vdesmedt/ElectronicLoad/Electonic/MainBoard.brd

## EAGLE design Electonic/MainBoard.brd (2020-11-04)

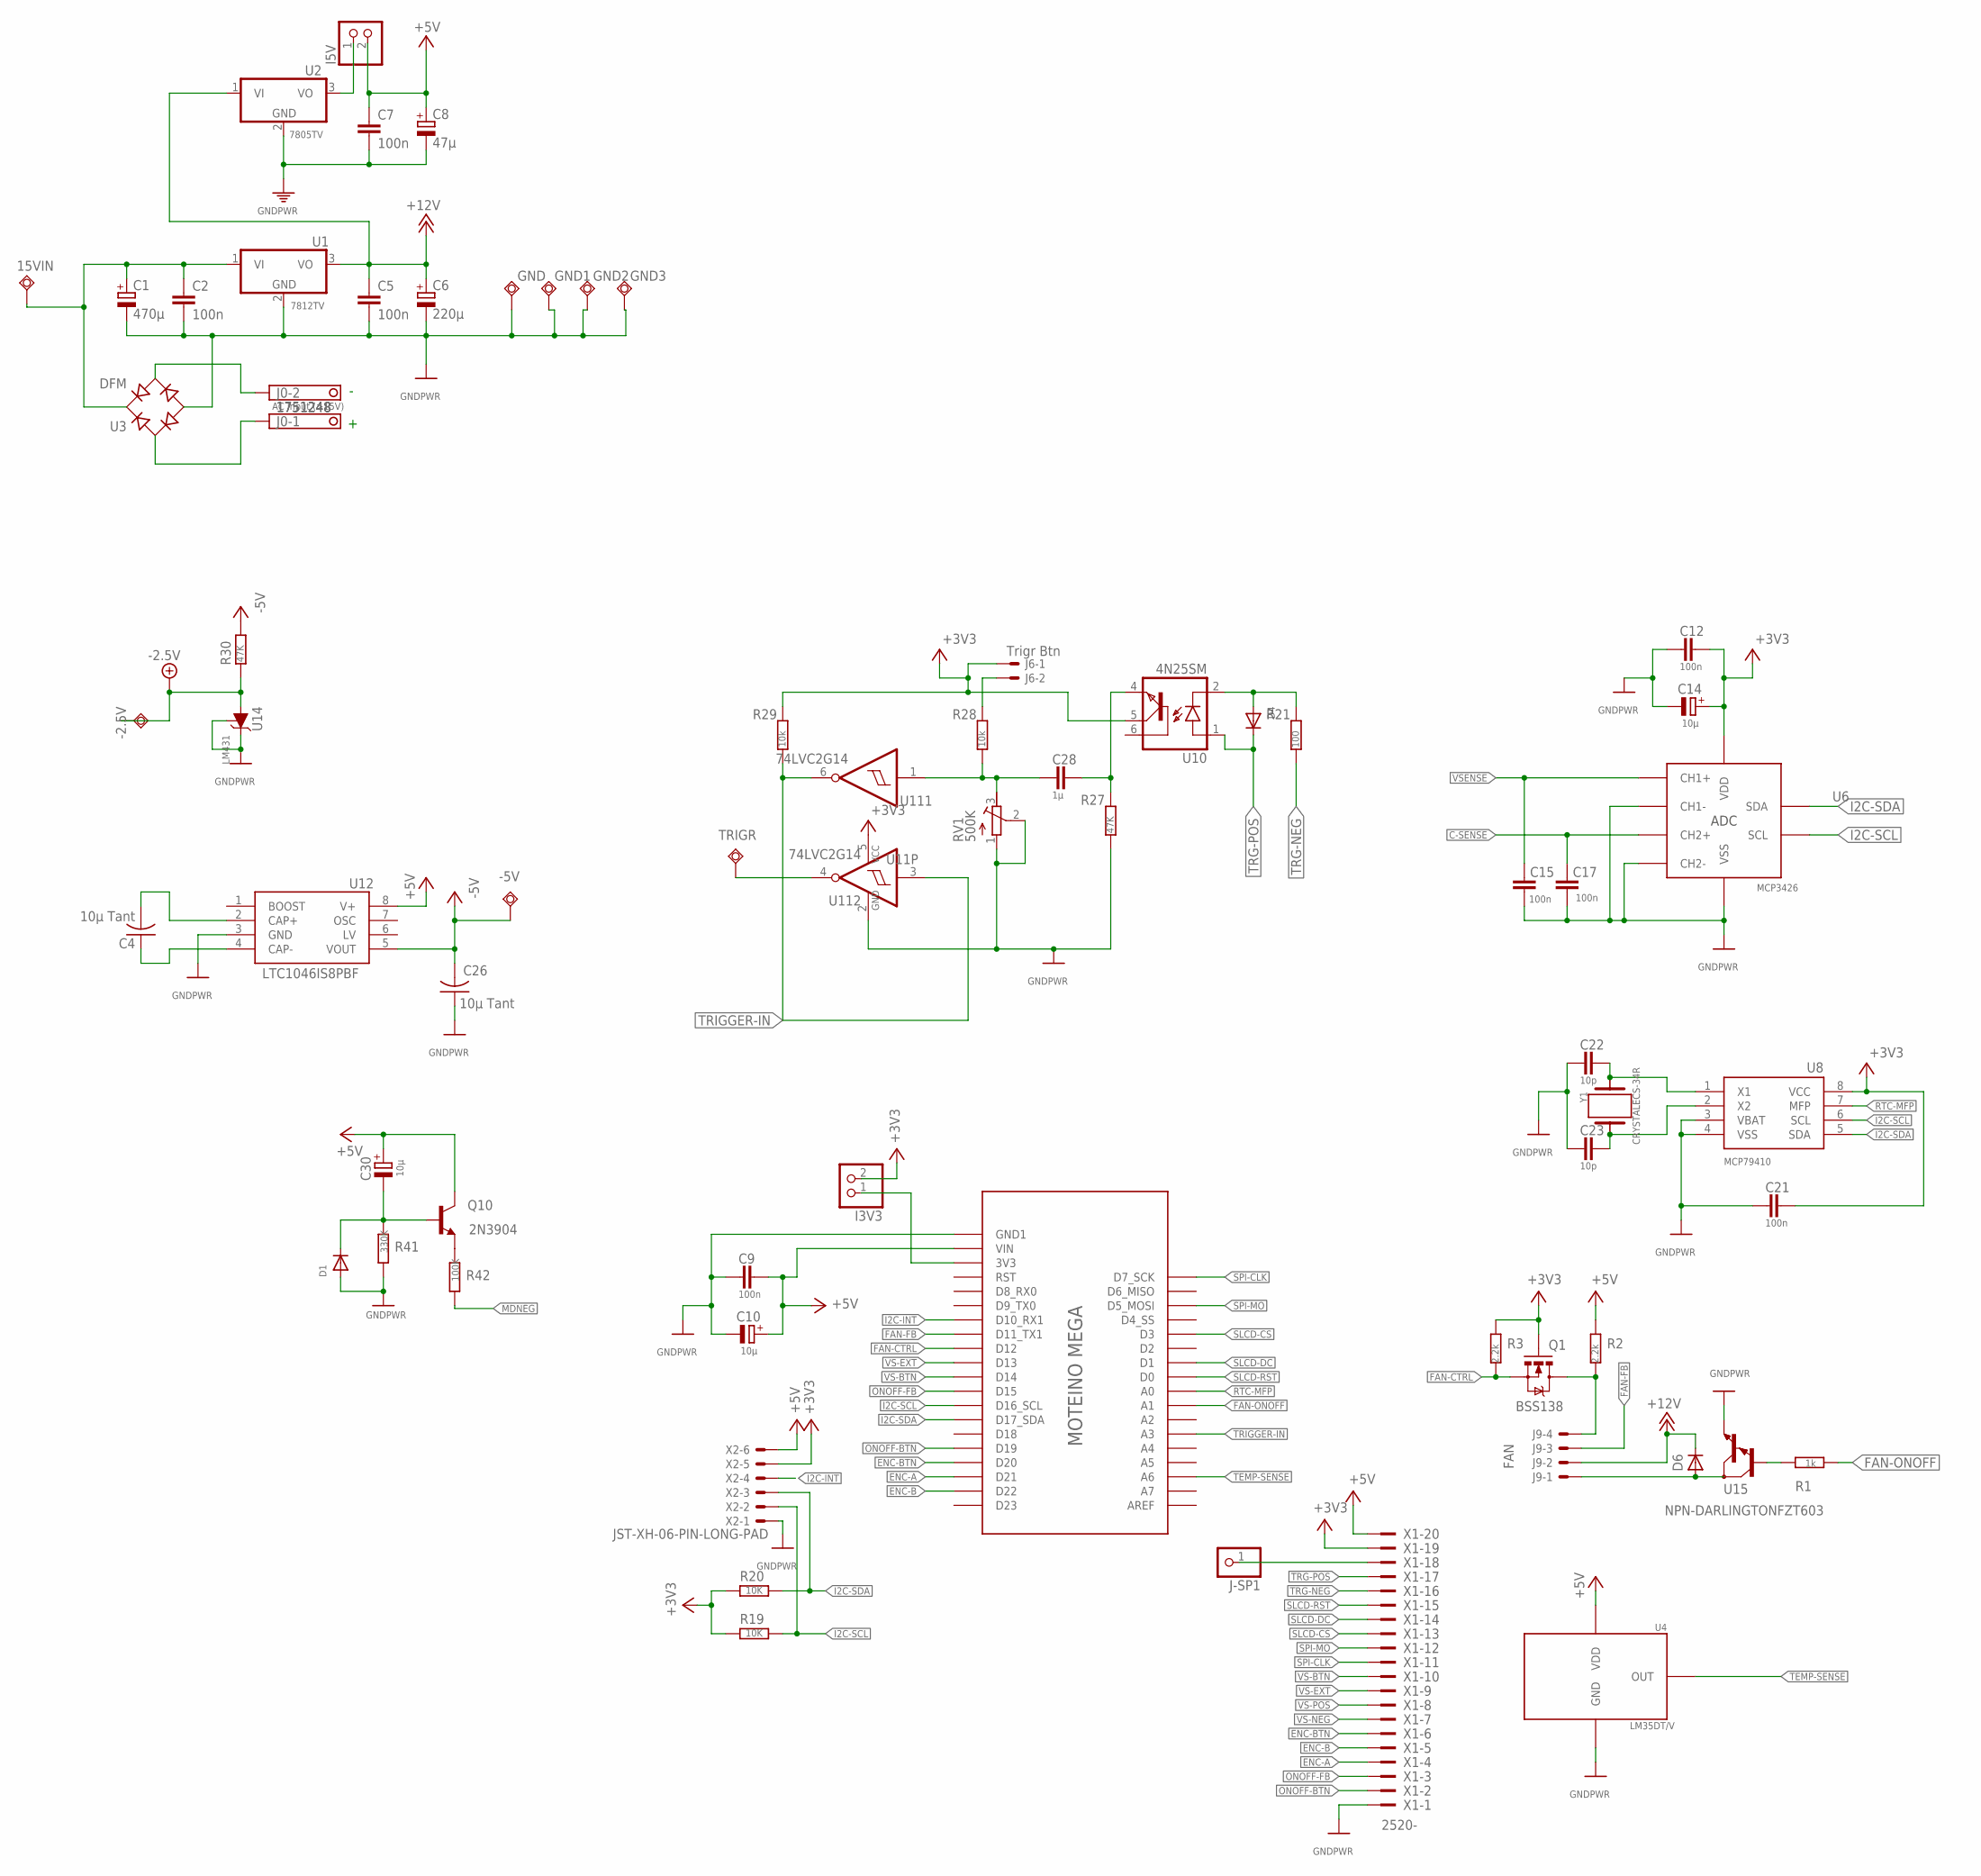
[picture p1: schematic MainBoard.sch, sheet 1]

Parts:
15VIN: TEST-POINT4952; TP-KEYSTONE-4952
-2.5V, -5V: TEST-POINT4952; TP-KEYSTONE-4952
C1: 470µ; E5-10,5
C2, C5, C7, C9, C12, C15, C17, C21: 100n; C0805K
C4, C26: 10µ Tant; C1210
C6: 220µ; E5-10,5
C8: 47µ; E5-5
C10, C14, C30: 10µ; E2-5
C22, C23: 10p; C0805K
C28: 1µ; C0805K
D1, D4: DIODESOD-323F; SOD-323F
D6: DIODE_SOD-123FL; SOD-123FL
GND, GND1, GND2, GND3: TEST-POINT4952; TP-KEYSTONE-4952
I3V3, I5V: PINHD-1X2; 1X02
J0: 1751248
J6: Trigr Btn; JST-XH-02-PACKAGE-ROUND-PAD
J9: FAN; JST-XH-04-PACKAGE-ROUND-PAD
J-SP1: PINHD-1X1; 1X01
Q1: BSS138; SOT23
Q10: 2N3904; TO92
R1: 1k; R0805
R2, R3: 2.2k; R0805
R19, R20: 10K; R0805
R21: 100; R0805
R27, R30: 47K; R0805
R28, R29: 10k; R0805
R41: 330K; R0805
R42: 100K; R0805
RV1: 500K; RTRIM3296W
TRIGR: TEST-POINT4952; TP-KEYSTONE-4952
U1: 7812TV; TO220V
U2: 7805TV; TO220V
U3: DFM
U4: LM35DT/V; TO220V
U6: MCP3426; SO8
U8: MCP79410; SOIC127P600X175-8N
U10: 4N25SM; DIL6-SMD
U11: 74LVC2G14; SOT23-6
U12: LTC1046IS8PBF; SOIC127P599X175-8N
U14: LM431; SOT23
U15: NPN-DARLINGTONFZT603; SOT223
U$1: MOTEINO_MEGA_SIMPLE
X1: 2520-; PAK100/2500-20
X2: JST-XH-06-PIN-LONG-PAD; JST-XH-06-PACKAGE-LONG-PAD
Y1: CRYSTALECS-34R; ECS32712534RRTR

Connections:
+3V3: C12.1, C14.+, C21.1, I3V3.2, J6.1, Q1.1 (G), R3.2, R19.2, R20.2, R29.2, U6.3 (VDD), U8.8 (VCC), U10.5 (COL), U11.5 (VCC), X1.19, X2.5
+5V: C7.1, C8.+, C9.1, C10.+, C30.+, I5V.2, Q10.1 (C), R2.2, U4.1 (VDD), U12.8 (V+), U$1.VIN, U$1.VIN_2 (VIN), X1.20, X2.6; also elsewhere on the board
+12V: C5.1, C6.+, D6.C, J9.2, U1.3 (VO), U2.1 (VI)
-2.5V: -2.5V.P$1, R30.1, U14.3 (A); also elsewhere on the board
-5V: -5V.P$1, C26.2, R30.2, U12.5 (VOUT); also elsewhere on the board
C-SENSE: C17.2, U6.7 (CH2+); also elsewhere on the board
ENC-A: U$1.D21, X1.4
ENC-B: U$1.D22, X1.5
ENC-BTN: U$1.D20, X1.6
FAN-CTRL: Q1.2 (S), R3.1, U$1.D12
FAN-CTRL-5V: J9.4, Q1.3 (D), R2.1
FAN-FB: J9.3, U$1.D11 (D11_TX1)
FAN-ONOFF: R1.1, U$1.A1
GND: C1.-, C2.2, C5.2, C6.-, C7.2, C8.-, C9.2, C10.-, C12.2, C14.-, C15.2, C17.1, C21.2, C22.2, C23.2, C26.1, D1.A, GND.P$1, GND1.P$1, GND2.P$1, GND3.P$1, R27.1, R41.2, RV1.1 (A), RV1.2 (S), U1.2 (GND), U2.2 (GND), U3.-, U4.2 (GND), U6.2 (CH1-), U6.6 (VSS), U6.8 (CH2-), U8.3 (VBAT), U8.4 (VSS), U11.2 (GND), U12.3 (GND), U14.1 (C), U14.2 (ADJ), U15.3 (E), U$1.GND1, U$1.GND_2 (GND1), X1.1, X2.1; also elsewhere on the board
I2C-INT: U$1.D10 (D10_RX1), X2.4
I2C-SCL: R19.1, U6.5 (SCL), U8.6 (SCL), U$1.D16 (D16_SCL), X2.2; also elsewhere on the board
I2C-SDA: R20.1, U6.4 (SDA), U8.5 (SDA), U$1.D17 (D17_SDA), X2.3; also elsewhere on the board
MDNEG: R42.2; also elsewhere on the board
unnamed: TRIGR.P$1, U11.4 (O)
unnamed: D6.A, J9.1, U15.2 (C), U15.4 (C)
unnamed: I5V.1, U2.3 (VO)
unnamed: I3V3.1, U$1.3V3, U$1.3V3_2 (3V3)
unnamed: 15VIN.P$1, C1.+, C2.1, U1.1 (VI), U3.+
unnamed: J0.1, U3.A1 (AC1)
unnamed: J0.2, U3.A2 (AC2)
unnamed: C4.2, U12.2 (CAP+)
unnamed: J-SP1.1, X1.18
unnamed: C4.1, U12.4 (CAP-)
unnamed: C28.2, R28.1, RV1.3 (E), U11.1 (I)
unnamed: C28.1, R27.2, U10.4 (EMI)
unnamed: D4.A, R21.2, U10.2 (C)
unnamed: J6.2, R28.2
unnamed: Q10.3 (E), R42.1
unnamed: C30.-, D1.C, Q10.2 (B), R41.1
ONOFF-BTN: U$1.D19, X1.2
ONOFF-FB: U$1.D15, X1.3
RTC-MFP: U8.7 (MFP), U$1.A0
RTCX1: C22.1, U8.1 (X1), Y1.1
RTCX2: C23.1, U8.2 (X2), Y1.2
SLCD-CS: U$1.D3, X1.13
SLCD-DC: U$1.D1, X1.14
SLCD-RST: U$1.D0, X1.15
SPI-CLK: U$1.D7 (D7_SCK), X1.11
SPI-MO: U$1.D5 (D5_MOSI), X1.12
TEMP-SENSE: U4.3 (OUT), U$1.A6
TRG-NEG: R21.1, X1.16
TRG-POS: D4.C, U10.1 (A), X1.17
TRIGGER-IN: R29.1, U11.3 (I), U11.6 (O), U$1.A3
U15IN: R1.2, U15.1 (B)
VS-BTN: U$1.D14, X1.10
VS-EXT: U$1.D13, X1.9
VS-NEG: X1.7; also elsewhere on the board
VS-POS: X1.8; also elsewhere on the board
VSENSE: C15.1, U6.1 (CH1+); also elsewhere on the board

Notes on the sheet:
AC Input (>15V)

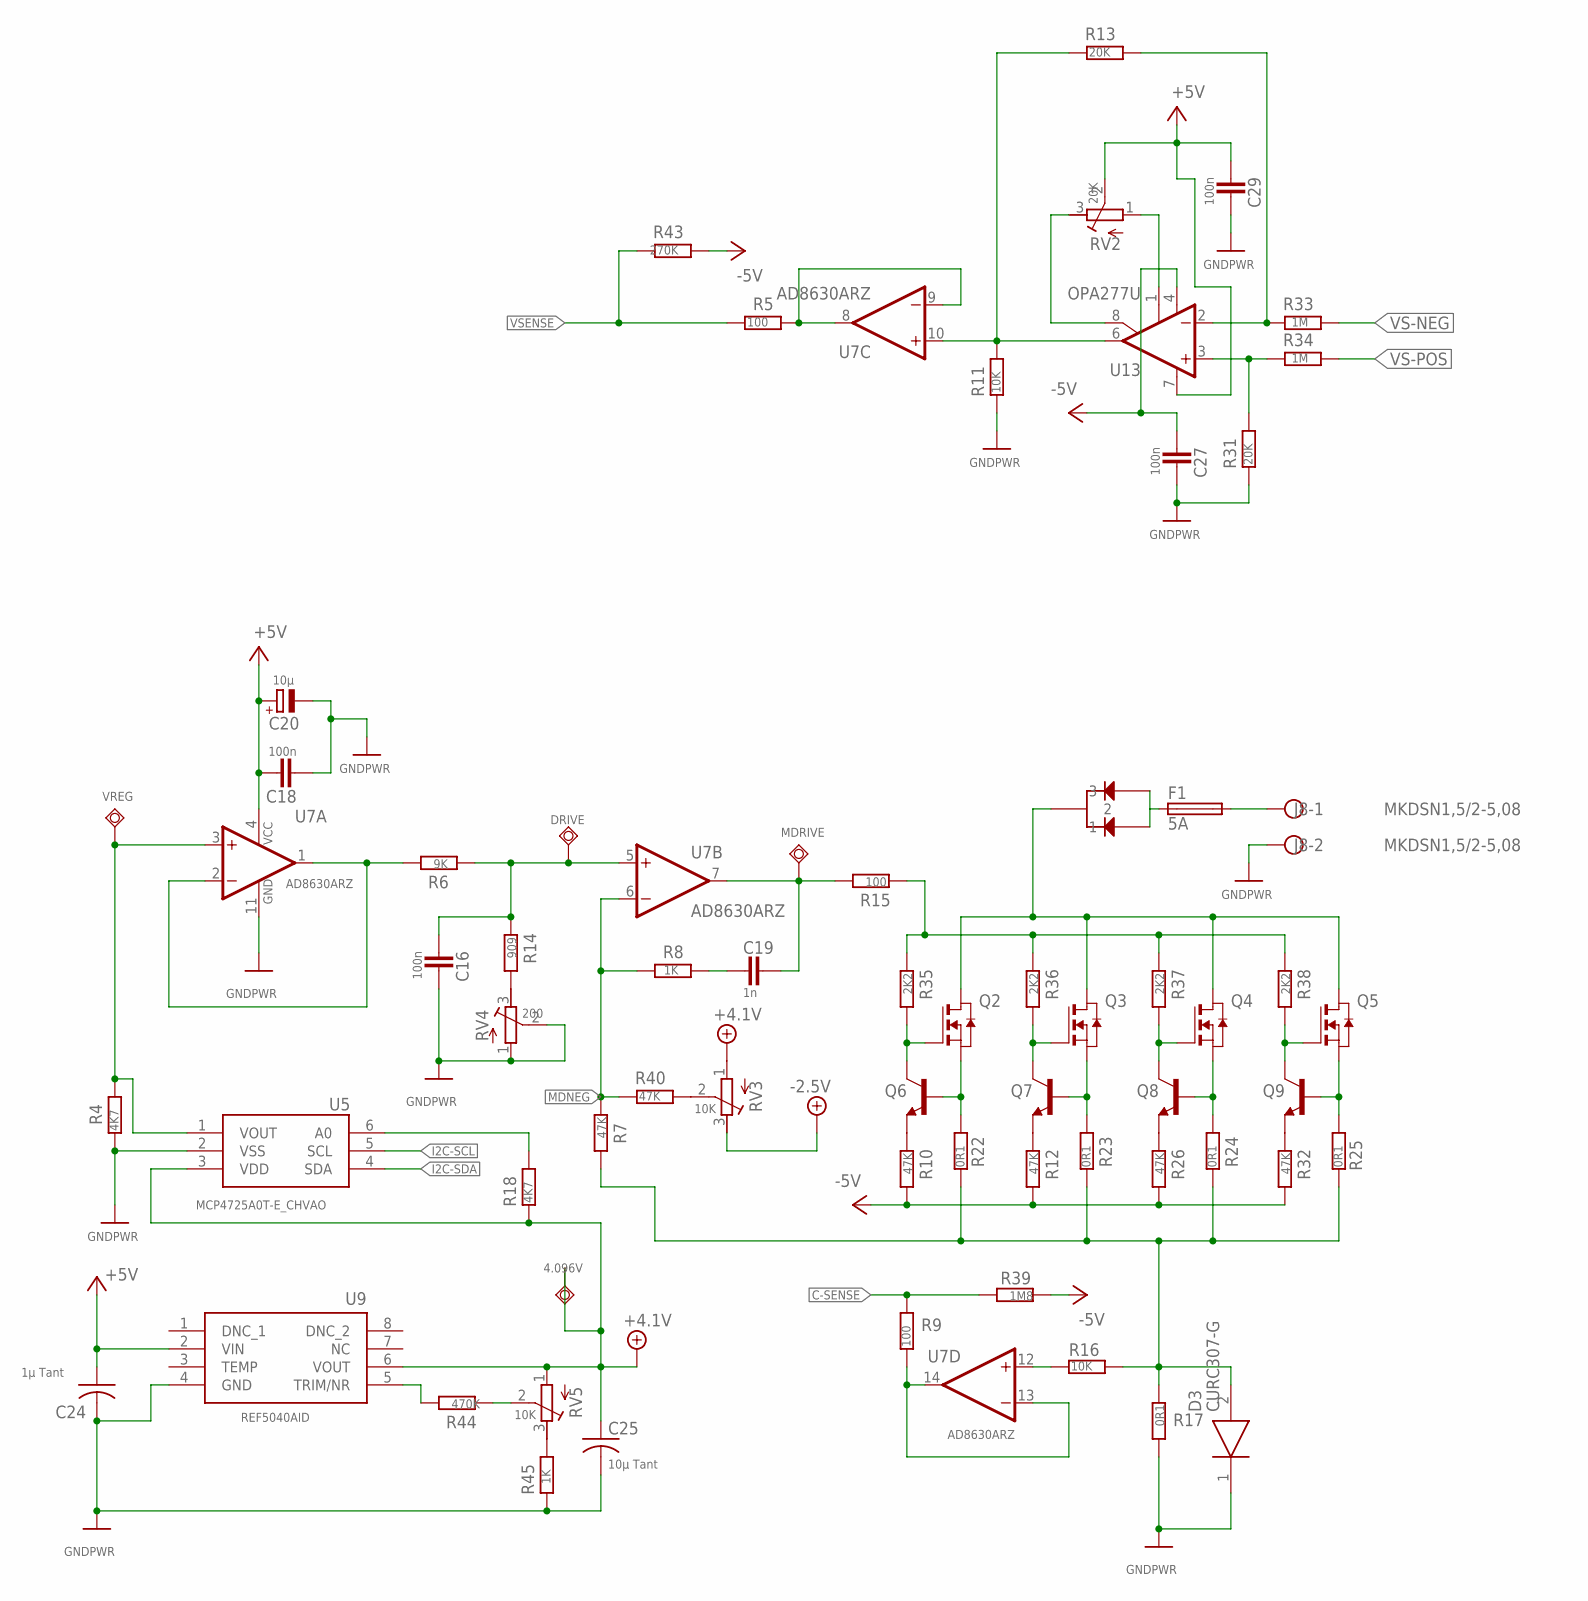
[picture p2: schematic MainBoard.sch, sheet 2]

Parts:
4.096V: TEST-POINT4952; TP-KEYSTONE-4952
C16, C18, C27, C29: 100n; C0805K
C19: 1n; C0805K
C20: 10µ; E2-5
C24: 1µ Tant; C1210
C25: 10µ Tant; C1210
D3: CURC307-G; DIOM7959X262N
D5: MBR41H100CT/V; TO220-VERT
DRIVE: TEST-POINT4952; TP-KEYSTONE-4952
F1: 5A; SHK20L
J8: MKDSN1,5/2-5,08
MDRIVE: TEST-POINT4952; TP-KEYSTONE-4952
Q2, Q3, Q4, Q5: SUP70040E/V; TO220-VERT
Q6, Q7, Q8, Q9: MPS2222A-NPN-TO92-CBE; TO92-CBE
R4, R18: 4K7; R0805
R5, R9, R15: 100; R0805
R6: 9K; R0805
R7, R10, R12, R26, R32: 47K; R0805
R8, R45: 1K; R0805
R11, R16: 10K; R0805
R13, R31: 20K; R1206
R14: 909; R1206
R17: 0R1; TO220-DPAC
R22, R23, R24, R25: 0R1; 0750V
R33, R34: 1M; R1206
R35, R36, R37, R38: 2K2; R0805
R39: 1M8; R0805
R40: 47K; R1206
R43: 270K; R0805
R44: 470K; R0805
RV2: 20K; RTRIM3296W
RV3, RV5: 10K; RTRIM3296W
RV4: 200; RTRIM3296W
U5: MCP4725A0T-E_CHVAO; SOT95P270X145-6N
U7: AD8630ARZ; SO14
U9: REF5040AID; SOIC127P600X175-8N
U13: OPA277U; SO08
VREG: TEST-POINT4952; TP-KEYSTONE-4952

Connections:
+4.1V: 4.096V.P$1, C25.1, R18.1, RV3.1 (A), RV5.1 (A), U5.3 (VDD), U9.6 (VOUT)
+5V: C18.1, C20.+, C24.1, C29.2, RV2.2 (S), U7.4 (VCC), U9.2 (VIN), U13.7 (V+); also elsewhere on the board
-2.5V: RV3.3 (E); also elsewhere on the board
-5V: C27.2, R10.2, R12.2, R26.2, R32.2, R39.1, R43.2, U13.4 (V-); also elsewhere on the board
C-SENSE: R9.2, R39.2; also elsewhere on the board
DACA0: R18.2, U5.6 (A0)
DACVO: R4.2, U5.1 (VOUT), U7.3 (+IN), VREG.P$1
GND: C16.1, C18.2, C20.-, C24.2, C25.2, C27.1, C29.1, D3.1 (K), J8.2, R4.1, R11.1, R17.2, R31.1, R45.1, RV4.1 (A), RV4.2 (S), U5.2 (VSS), U7.11 (GND), U9.4 (GND); also elsewhere on the board
I2C-SCL: U5.5 (SCL); also elsewhere on the board
I2C-SDA: U5.4 (SDA); also elsewhere on the board
MDNEG: R7.1, R8.1, R40.1, U7.6 (-IN); also elsewhere on the board
unnamed: R44.2, U9.5 (TRIM/NR)
unnamed: R45.2, RV5.3 (E)
unnamed: R44.1, RV5.2 (S)
unnamed: R6.2, U7.1 (OUT), U7.2 (-IN)
unnamed: C16.2, DRIVE.P$1, R6.1, R14.1, U7.5 (+IN)
unnamed: R13.2, R33.1, U13.2 (-IN)
unnamed: R14.2, RV4.3 (E)
unnamed: C19.1, MDRIVE.P$1, R15.2, U7.7 (OUT)
unnamed: Q2.1 (G), Q6.C, R35.2
unnamed: C19.2, R8.2
unnamed: Q3.1 (G), Q7.C, R36.2
unnamed: Q4.1 (G), Q8.C, R37.2
unnamed: Q5.1 (G), Q9.C, R38.2
unnamed: R15.1, R35.1, R36.1, R37.1, R38.1
unnamed: Q6.E, R10.1
unnamed: Q7.E, R12.1
unnamed: Q8.E, R26.1
unnamed: Q2.3 (S), Q6.B, R22.2
unnamed: Q9.E, R32.1
unnamed: Q3.3 (S), Q7.B, R23.2
unnamed: Q4.3 (S), Q8.B, R24.2
unnamed: Q5.3 (S), Q9.B, R25.2
unnamed: R40.2, RV3.2 (S)
unnamed: D3.2 (A), R7.2, R16.2, R17.1, R22.1, R23.1, R24.1, R25.1
unnamed: D5.2, Q2.2 (D), Q3.2 (D), Q4.2 (D), Q5.2 (D)
unnamed: R16.1, U7.12 (+IN)
unnamed: R9.1, U7.13 (-IN), U7.14 (OUT)
unnamed: D5.1, D5.3, F1.1A (1), F1.1B (1)
unnamed: F1.2A (2), F1.2B (2), J8.1
unnamed: R31.2, R34.1, U13.3 (+IN)
unnamed: RV2.3 (E), U13.8 (CMP2)
unnamed: RV2.1 (A), U13.1 (CMP1)
unnamed: R5.2, U7.8 (OUT), U7.9 (-IN)
U13-O: R11.2, R13.1, U7.10 (+IN), U13.6 (OUT)
VS-NEG: R33.2; also elsewhere on the board
VS-POS: R34.2; also elsewhere on the board
VSENSE: R5.1, R43.1; also elsewhere on the board

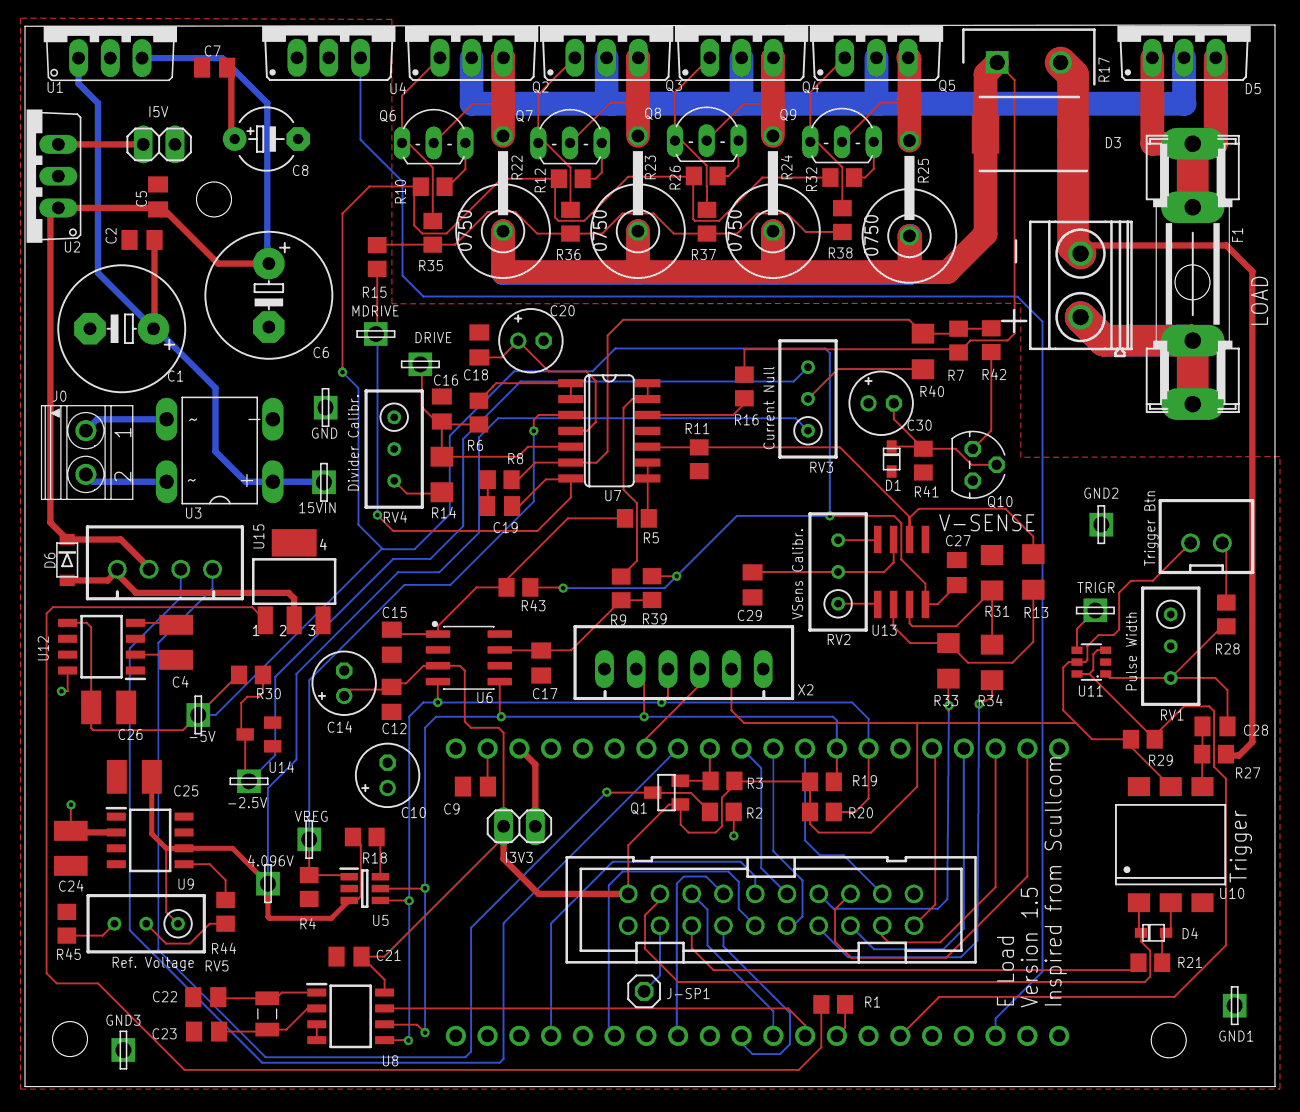
[picture p3: board MainBoard.brd from above]

Board: 2 copper layers, 100.0 x 84.9 mm, 131 parts (1 on the bottom side), 91 nets.
