vdesmedt/ElectronicLoad/Electonic/ControlPanel.brd

## EAGLE design Electonic/ControlPanel.brd (2020-11-04)

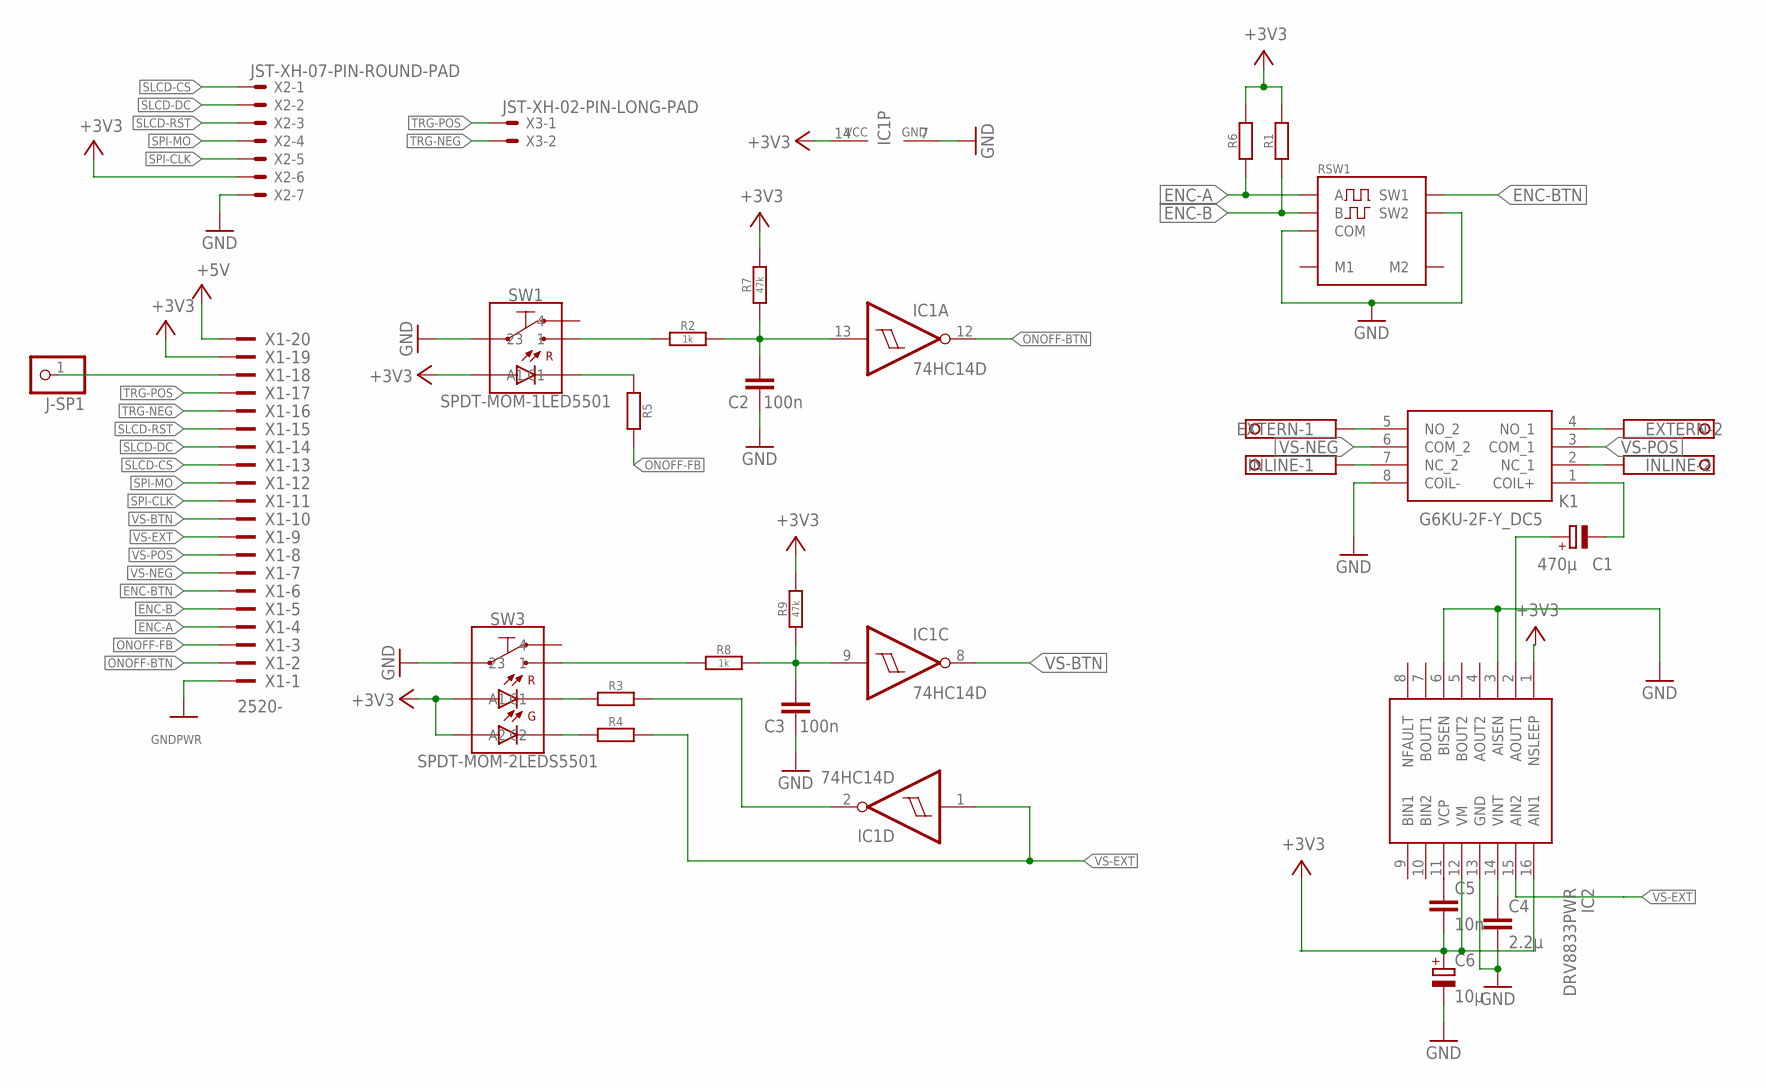
[picture p4: schematic ControlPanel.sch]

Parts:
C1: 470µ; E5-10,5
C2, C3: 100n; 0805
C4: 2.2µ; 0805
C5: 10n; 0805
C6: 10µ; E2-5
EXTERN: 1751248
IC1: 74HC14D; SO14
IC2: DRV8833PWR; SOP65P640X120-16N
INLINE: 1751248
J-SP1: PINHD-1X1; 1X01
K1: G6KU-2F-Y_DC5; G6KU2FYDC5
R1, R3, R4, R5, R6: RESISTOR1206; 1206
R2, R8: 1k; 0805
R7, R9: 47k; 0805
RSW1: SW-EC11E; EC11E
SW1: SPDT-MOM-1LED5501; 5501-BTN-1LED
SW3: SPDT-MOM-2LEDS5501; 5501-BTN-2LEDS
X1: 2520-; PAK100/2500-20
X2: JST-XH-07-PIN-ROUND-PAD; JST-XH-07-PACKAGE-ROUND-PAD
X3: JST-XH-02-PIN-LONG-PAD; JST-XH-02-PACKAGE-LONG-PAD

Connections:
+3V3: C5.2, C6.+, IC1.14 (VCC), IC2.1 (NSLEEP), IC2.12 (VM), IC2.16 (AIN1), R1.2, R6.2, R7.2, R9.2, SW1.5 (A1), SW3.5 (A1), SW3.8 (A2), X1.19, X2.6
+5V: X1.20
ENC-A: R6.1, RSW1.A, X1.4
ENC-B: R1.1, RSW1.B, X1.5
ENC-BTN: RSW1.SW1, X1.6
GND: C2.1, C3.1, C4.2, C6.-, IC1.7 (GND), IC2.3 (AISEN), IC2.6 (BISEN), IC2.13 (GND), K1.8 (COIL-), RSW1.C (COM), RSW1.SW2, SW1.2 (23), SW1.3 (23), SW3.2 (23), SW3.3 (23), X1.1, X2.7
unnamed: R8.1, SW3.1
unnamed: EXTERN.1, K1.5 (NO_2)
unnamed: R5.1, SW1.8 (C1)
unnamed: R2.1, SW1.1
unnamed: R4.1, SW3.7 (C2)
unnamed: R3.1, SW3.6 (C1)
unnamed: INLINE.1, K1.7 (NC_2)
unnamed: C2.2, IC1.13 (I), R2.2, R7.1
unnamed: INLINE.2, K1.2 (NC_1)
unnamed: EXTERN.2, K1.4 (NO_1)
unnamed: C1.-, K1.1 (COIL+)
unnamed: C1.+, IC2.2 (AOUT1)
unnamed: C4.1, IC2.14 (VINT)
unnamed: C3.2, IC1.9 (I), R8.2, R9.1
unnamed: C5.1, IC2.11 (VCP)
unnamed: J-SP1.1, X1.18
ONOFF-BTN: IC1.12 (O), X1.2
ONOFF-FB: R5.2, X1.3
SLCD-CS: X1.13, X2.1
SLCD-DC: X1.14, X2.2
SLCD-RST: X1.15, X2.3
SPI-CLK: X1.11, X2.5
SPI-MO: X1.12, X2.4
TRG-NEG: X1.16, X3.2
TRG-POS: X1.17, X3.1
V-INL: IC1.2 (O), R3.2
VS-BTN: IC1.8 (O), X1.10
VS-EXT: IC1.1 (I), IC2.15 (AIN2), R4.2, X1.9
VS-NEG: K1.6 (COM_2), X1.7
VS-POS: K1.3 (COM_1), X1.8

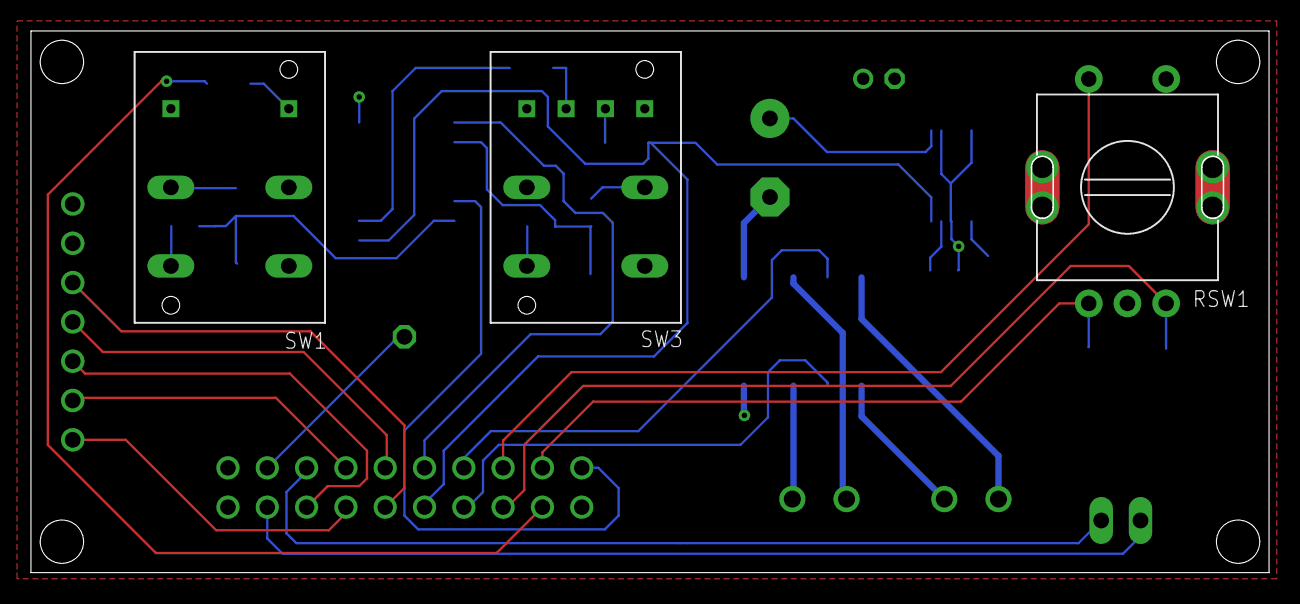
[picture p5: board ControlPanel.brd from above]

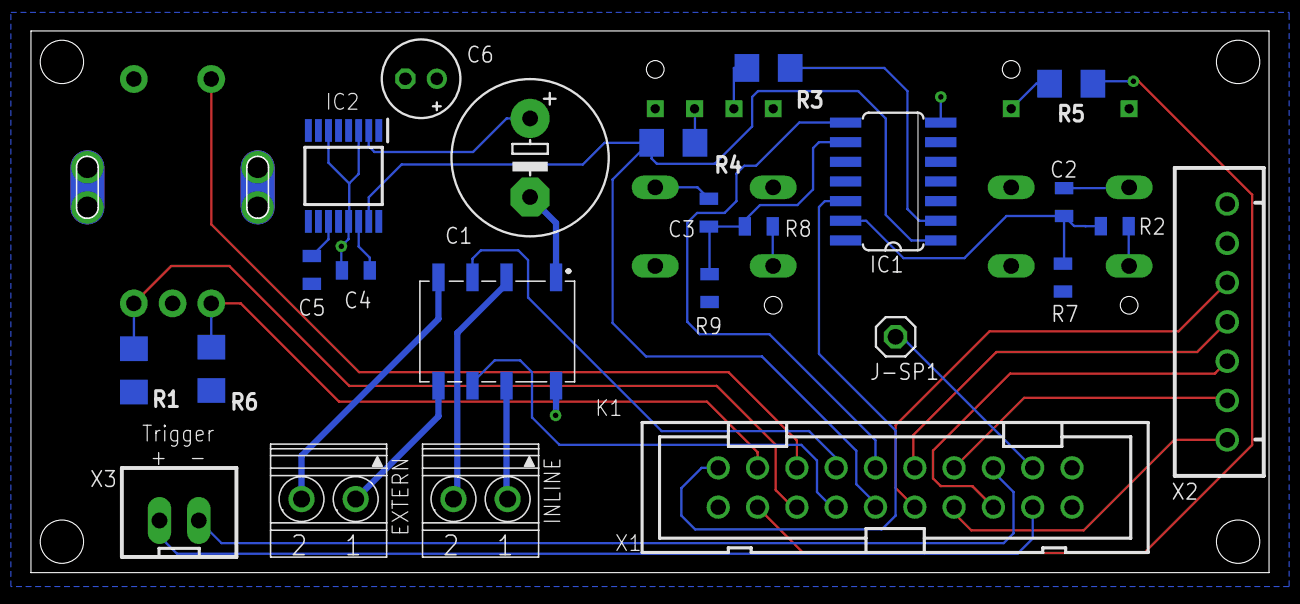
[picture p6: board ControlPanel.brd from below]

Board: 2 copper layers, 80.0 x 35.0 mm, 27 parts (24 on the bottom side), 35 nets.
