vdesmedt/ElectronicLoad/Electonic/TriggerMount.brd

## EAGLE design Electonic/TriggerMount.brd (2020-11-04)

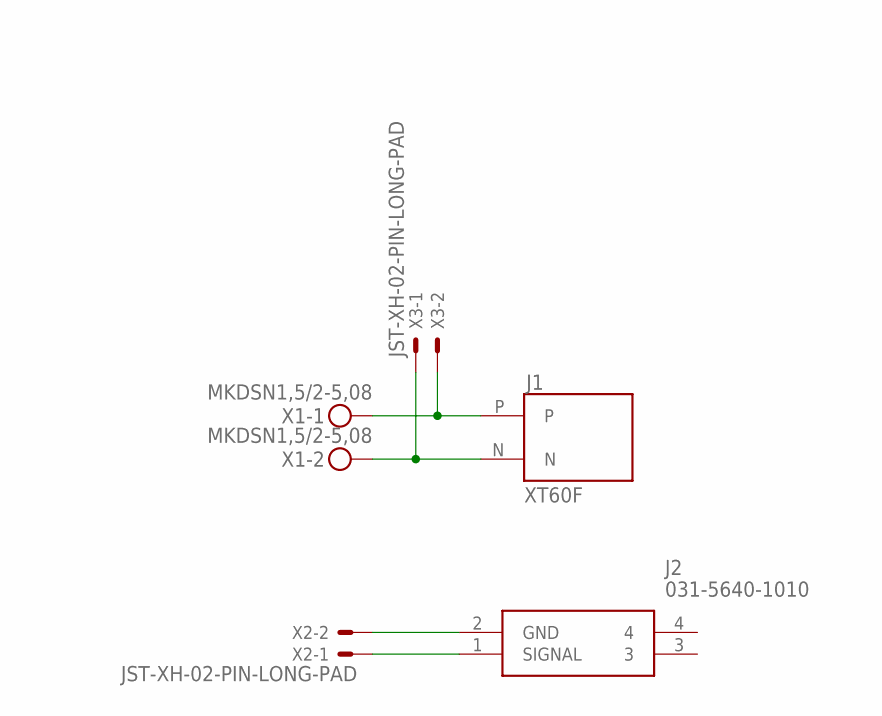
[picture p7: schematic TriggerMount.sch]

Parts:
J1: XT60F; XT60PW
J2: 031-5640-1010; 03156401010
X1: MKDSN1,5/2-5,08
X2, X3: JST-XH-02-PIN-LONG-PAD; JST-XH-02-PACKAGE-LONG-PAD

Connections:
unnamed: J1.N, X1.2, X3.1
unnamed: J1.P, X1.1, X3.2
unnamed: J2.2 (GND), X2.2
unnamed: J2.1 (SIGNAL), X2.1

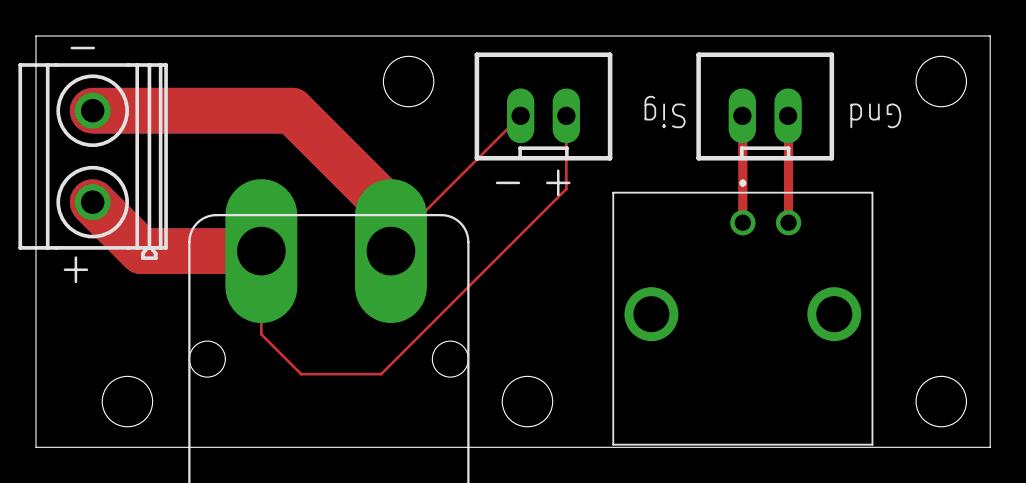
[picture p8: board TriggerMount.brd from above]

Board: 2 copper layers, 53.0 x 22.9 mm, 5 parts (0 on the bottom side), 4 nets.
