vdesmedt/ElectronicLoad/Firmware/include/Segoe_8.h

/*
  Fontname: -*-Segoe UI Light-Medium-R-Normal--11-80-96-96-c-6--fontspecific
  Copyright: You may wish to put your copyright here
  Glyphs: 245/245
  BBX Build Mode: 0
*/
const uint8_t Segoes_8[2774] U8G2_FONT_SECTION("Segoes_8") = 
  "\365\0\3\2\4\4\3\5\5\16\15\377\376\10\376\10\376\2\35\3\216\12\271\13\11\205\205\27\67\337\206\1"
  "\14\16f\205X\332\220\14C\62DJ$\1\15\5\0\204\21\16\11\205\205\27\67\337\206\1\17\11\205\205"
  "\27\67\337\206\1\20\11\205\205\27\67\337\206\1\21\11\205\205\27\67\337\206\1\22\11\205\205\27\67\337\206\1"
  "\23\11\205\205\27\67\337\206\1\24\11\205\205\27\67\337\206\1\25\11\205\205\27\67\337\206\1\26\11\205\205\27"
  "\67\337\206\1\27\11\205\205\27\67\337\206\1\30\11\205\205\27\67\337\206\1\31\11\205\205\27\67\337\206\1\32"
  "\11\205\205\27\67\337\206\1\33\11\205\205\27\67\337\206\1\34\11\205\205\27\67\337\206\1\35\11\205\205\27\67"
  "\337\206\1\36\11\205\205\27\67\337\206\1\37\11\205\205\27\67\337\206\1 \5\0\204\23!\7\201\205\23\227"
  "\0\42\7#\264\24\211\22#\17v\214\227Y\222\14S\222\14K-\211\0$\20\245}V\331\240DI"
  "&jI\224\14Z\4%\22\211\204\71ZT\311\242$Tr$\21\223\250\67\5&\20\207\205X[\224"
  "%\232\30E\232\222IS\0'\6!\265\22\2(\11\242u\63\211\322S\22)\13\242u\23I\224t"
  "Q\22\0*\11D\244T\211\22U\2+\12U\205Wa\64Ha\4,\7\62u\62J\2-\6\23"
  "\225\24\3.\6\21\205\22\1/\13\224|t\245,\312JY\6\60\13\205\205\66\213\262\271-\312\2\61"
  "\10\203\204\64K\324\7\62\13\204\205\66[I\61eC\0\63\14\204\205\26c\226\210Y\66$\0\64\16"
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
  "\222!\372\13\225\205vu \363\226\14\1\373\13\225\205VY\22g\336\222!\374\13\205\205\66\211\232y"
  "K\206\0\375\17\265tuu \323\222R\222\205Y\246\1\376\15\245u\26a\305\244\331\6%\14\1\377"
  "\17\245t\65\211\232iI)\311\302,\323\0\0\0\0\4\377\377\0";
