vdesmedt/ElectronicLoad/Firmware/include/lucida.h

/*
  Fontname: -*-EurostileTRegExt-Medium-R-Normal--11-80-96-96-c-6--fontspecific
  Copyright: You may wish to put your copyright here
  Glyphs: 224/226
  BBX Build Mode: 0
*/
const uint8_t Lucida_8[2708] U8G2_FONT_SECTION("Lucida_8") = 
  "\340\0\4\3\5\4\3\5\6\27\15\377\375\7\376\10\376\1z\3#\12w \5\0\10G!\7\341\12"
  "G\250\10\42\7bJ\311\230\10#\17\350\12U\211I\22s\222\344$&\23\0$\23)\373T\212\272"
  "\210\211\221\211\272\212\221\211\71\220\12\2%\31\356\12\341 \312$*(\42\202\42H\42(\302\42(*"
  "$(\21\5\0&\22\352\12\327\60\212\12\212\223\220\211\10\222H&r\21'\6aJE\30(\12C"
  "\353\310\30\311O$\0)\12C\351H\220\11\311/\4*\13\205JO\11\251\30\211\210\0+\14\347\12"
  "\323\11Ks\23\226\6\0,\6A\372F\20-\6$(I .\6!\12G\10/\13(\347\320\13"
  "K\27\226w\0\60\14\350\12\325\260\10\323Y\204\5\0\61\13\344\14U\221\210\20\211\311\1\62\16\350\12"
  "U\270\10\213\13;\10\211;\10\63\15\350\12U\70\20\213\213!\24;\20\64\20\350\12\325\22\222\210I"
  "!\24q\20\26\27\1\65\15\350\12U\70\220;\214\23;\210\0\66\16\350\12\325\70\10\223;\20\23\213"
  "\260\0\67\13\350\12U\70\210\13\313+\0\70\16\350\12U\70\20\23\213\260\10\23;\20\71\16\350\12\325"
  "\260\10\23;\220\23;\210\0:\7\241\12G\210\11;\7\301\372F\210\21<\12\245\30\315\221\20\211\232"
  "\12=\7g*S\270;>\13\245\30M\220\222\212\230\10\2\77\14\346\12Q\70\212\212\31\211\215\1@"
  "\22\11\373\324\270\210\223\250\230\11\231\11\261 \13\271\0A\17\351\10S\22\213\210\212\11Jr\21'\27"
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
  "\350\0\373\12\346\12Q\21\14\322\350\0\374\13\346\12\321\210\220\13\322\350\0\375\23F\331L\212\13\212\210"
  "\211\10\211\211\10\22\12\222\221\1\376\16'\353P\10\13\263\210Ru\21\26\6\377\24F\331\314\210\220\13"
  "\212\210\211\10\211\211\10\22\12\222\221\1\0\0\0\4\377\377\0";
