vdesmedt/ElectronicLoad/Firmware/include/MMDigit08.h

/*
  Fontname: MMDigit08
  Copyright: Created with Fony 1.4.7
  Glyphs: 256/256
  BBX Build Mode: 0
*/
const uint8_t MMDigit08[1694] U8G2_FONT_SECTION("MMDigit08") = 
  "\0\0\3\2\3\4\4\4\4\5\11\0\376\7\376\0\0\1\233\2\326\6\201\0\5\0D\7\1\11-T"
  "W\266\64\205\3\2\12<\304\216\62H\322\360\20\3\6\13D\306\0\4\6\33D\306\66\5\6+D\306"
  "v\6\5\0D\7\7\5\0D\7\10\5\0D\7\11\5\0D\7\12\5\0D\7\13\5\0D\7\14"
  "\5\0D\7\15\5\0D\7\16\5\0D\7\17\5\0D\7\20\5\0D\7\21\5\0D\7\22\5\0"
  "D\7\23\5\0D\7\24\5\0D\7\25\5\0D\7\26\5\0D\7\27\5\0D\7\30\5\0D\7"
  "\31\5\0D\7\32\5\0D\7\33\5\0D\7\34\5\0D\7\35\5\0D\7\36\5\0D\7\37\5"
  "\0D\7 \5\0D\7!\7\271\304\305\240\4\42\5\0D\7#\5\0D\7$\5\0D\7%\5"
  "\0D\7&\5\0D\7'\5\0D\7(\5\0D\7)\5\0D\7*\5\0D\7+\5\0D"
  "\7,\5\0D\7-\5\0D\7.\6\11DE\0/\5\0D\7\60\14=D\317\222ii\246%"
  "\13\0\61\6)N\207\42\62\13=D\317\32&K\230.\0\63\13\274D\307\230\15a\66$\0\64\11"
  "-LG\246%k\30\65\13=D\317\22\246k\230,\0\66\14=D\317\22\246K\246%\13\0\67\11"
  "\264L\307\230\345@\26\70\14=D\317\222i\311\222i\311\2\71\14=D\317\222i\311\32&\13\0:"
  "\6!LE\24;\6\231\324F\22<\10<D_\324\330\0=\10\35T\307\240\16\2>\10\274DG"
  "\330\324\6\77\12=D\317\222\65\346P\4@\5\0D\7A\13=DW\226\324\206!\263\5B\15="
  "D\307\20U\242d\252D\203\2C\12=D\317\222\211m\311\2D\17=D\307\20U\242$J\242$"
  "\32\24\0E\13=D\307\61\34\222\60\34\4F\12=D\307\61\34\222\260\10G\13=D\317\222\211\245"
  "-Y\0H\12=DGf\33\206\314\26I\10\273D\307\22u\31J\12=D\327\26\266D\221\4K"
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
  "\7\360\5\0D\7\361\5\0D\7\362\5\0D\7\363\5\0D\7\364\12\65D\317\222\331\222\212\1\365"
  "\5\0D\7\366\5\0D\7\367\5\0D\7\370\5\0D\7\371\5\0D\7\372\5\0D\7\373\5\0"
  "D\7\374\5\0D\7\375\5\0D\7\376\5\0D\7\377\5\0D\7\0\0\0\4\377\377\0";
