vdesmedt/ElectronicLoad/Firmware/include/MMDigit12.h

#ifndef _mmdigit12_h
#define _mmdigit12_h

/*
  Fontname: MMDigit12
  Copyright: Created with Fony 1.4.7
  Glyphs: 87/256
  BBX Build Mode: 0
*/
const uint8_t MMDigit12[562] U8G2_FONT_SECTION("MMDigit12") =
    "W\0\3\3\3\4\4\4\4\6\14\0\0\14\0\0\0\1\223\0\0\2\25\0\11\63\364N\212\244\42\11"
    "\1\12\63\364FDKR\4\0\2\5\0\304\7\3\5\0\304\7\4\5\0\304\7\5\5\0\304\7\6\5"
    "\0\304\7\7\5\0\304\7\10\5\0\304\7\11\5\0\304\7\12\5\0\304\7\13\5\0\304\7\14\5\0\304"
    "\7\15\5\0\304\7\16\5\0\304\7\17\5\0\304\7\20\5\0\304\7\21\5\0\304\7\22\5\0\304\7\23"
    "\5\0\304\7\24\5\0\304\7\25\5\0\304\7\26\5\0\304\7\27\5\0\304\7\30\5\0\304\7\31\5\0"
    "\304\7\32\5\0\304\7\33\5\0\304\7\34\5\0\304\7\35\5\0\304\7\36\5\0\304\7\37\5\0\304\7"
    " \5\0\304\7!\5\0\304\7\42\5\0\304\7#\5\0\304\7$\5\0\304\7%\5\0\304\7&\5"
    "\0\304\7'\5\0\304\7(\5\0\304\7)\5\0\304\7*\5\0\304\7+\5\0\304\7,\5\0\304"
    "\7-\5\0\304\7.\6\11LE\0/\5\0\304\7\60\15^\314\17%\250\61\34\324\30\241\0\61\7"
    "\311\326\7\205\0\62\14^\314\17\71\232\205\22\315L\1\63\14\335\314\7\65\230I\32L\254\0\64\13N"
    "\324GPc\204\34\315\0\65\14^\314\17%\232\231\34\315B\1\66\15^\314\17%\232\231\22\324\30\241"
    "\0\67\13\325\324\7\65\230\35\24\314\0\70\16^\314\17%\250\61B\11j\214P\0\71\15^\314\17%"
    "\250\61B\216f\241\0:\5\0\304\7;\5\0\304\7<\5\0\304\7=\5\0\304\7>\5\0\304\7"
    "\77\5\0\304\7@\5\0\304\7A\14^\314\17%\250\61B\11\352\30B\5\0\304\7C\5\0\304\7"
    "D\5\0\304\7E\5\0\304\7F\5\0\304\7G\5\0\304\7H\5\0\304\7I\5\0\304\7J\5"
    "\0\304\7K\5\0\304\7L\5\0\304\7M\5\0\304\7N\5\0\304\7O\5\0\304\7P\5\0\304"
    "\7Q\5\0\304\7R\5\0\304\7S\5\0\304\7T\5\0\304\7U\5\0\304\7V\20]\314GL"
    "o\221\244H(\22\212\304B\0\0\0\0\4\377\377\0";
#endif
