vdesmedt/ElectronicLoad/Firmware/src/debug.h

#include <Arduino.h>

#if EDCL_DEBUG
#define DEB_BUFFER_LEN 100
#define debug_printa(msg, ...)                                            \
    do                                                                    \
    {                                                                     \
        char buffer[DEB_BUFFER_LEN];                                      \
        snprintf(buffer, DEB_BUFFER_LEN, (const char *)msg, __VA_ARGS__); \
        Serial.print(buffer);                                             \
    } while (0)
#define debug_printb(pre, msg, ...)                                       \
    do                                                                    \
    {                                                                     \
        Serial.print(pre);                                                \
        char buffer[DEB_BUFFER_LEN];                                      \
        snprintf(buffer, DEB_BUFFER_LEN, (const char *)msg, __VA_ARGS__); \
        Serial.print(buffer);                                             \
    } while (0)
#define debug_print(msg)   \
    do                     \
    {                      \
        Serial.print(msg); \
    } while (0)
#else
#define debug_printa(msg, ...)
#define debug_printb(pre, msg, ...)
#define debug_print(msg)
#endif
