vdesmedt/ElectronicLoad/Firmware/src/specialLcdChar.h

#include <Arduino.h>
#include <LiquidCrystal_PCF8574.h>
#include "define.h"

void setupSPecialLcdChars(LiquidCrystal_PCF8574 *lcd1)
{
    byte thermo_l0[]{
        B00100,
        B01010,
        B01010,
        B01010,
        B01010,
        B10001,
        B10001,
        B01110};
    byte thermo_l1[]{
        B00100,
        B01010,
        B01010,
        B01010,
        B01010,
        B10001,
        B11111,
        B01110};

    byte thermo_l2[]{
        B00100,
        B01010,
        B01010,
        B01010,
        B01110,
        B11111,
        B11111,
        B01110};

    byte thermo_l3[]{
        B00100,
        B01110,
        B01110,
        B01110,
        B01110,
        B11111,
        B11111,
        B01110};
    byte batt[] = {
        B00110,
        B01111,
        B01001,
        B01001,
        B01111,
        B01111,
        B01111,
        B00000};
    byte menuUp[] = {
        B00100,
        B01110,
        B10101,
        B00100,
        B11100,
        B00000,
        B00000,
        B00000};
    byte watch[] = {
        B00000,
        B01110,
        B10011,
        B10101,
        B10001,
        B01110,
        B00000,
        B00000};
    lcd1->createChar(SC_BATT, batt);
    lcd1->createChar(SC_MENU_UP, menuUp);
    lcd1->createChar(SC_THERMO_L0, thermo_l0);
    lcd1->createChar(SC_THERMO_L1, thermo_l1);
    lcd1->createChar(SC_THERMO_L2, thermo_l2);
    lcd1->createChar(SC_THERMO_L3, thermo_l3);
    lcd1->createChar(SC_WATCH, watch);
}
