vdesmedt/ElectronicLoad/(commit log)

2020-05-09 MovingAvergae on temperature
2020-05-09 Two level fan speed with Hysteresis
2020-05-09 Fix current reading
2020-05-10 Optimize EncoderButton timings
2020-05-10 Fan Speed Icon
2020-05-16 Display issues with Current
    [main.cpp, specialLcdChar.h]
2020-05-16 Switch off when changing mode
2020-05-18 Trigger Pin Config
2020-05-18 Optimize memory footprint (Special Chars)
2020-05-21 Battery Curoff
2020-05-21 Fixed suspicious Batt Cell Count
    [Settings.h, header.h, main.cpp, menumg.h, specialLcdChar.h]
2020-05-22 Logging Interval + Fan level
2020-09-15 Moved to Atmel1284 & SPI LCD
2020-09-16 Replace TimerOne with TimerOneThree to support Atmega1284 PWM on Pin12 (used by Timer1)
    [header.h, main.cpp]
2020-09-16 Fan fine tuning
2020-09-16 Remove old Fan Pin Number
2020-10-20 Mainboard V1.5 with VSense Button Connected
2020-11-04 Folder Reorg + Add Eagle Files
    [ControlPanel.brd, ControlPanel.sch, MainBoard.brd, MainBoard.sch, TriggerMount.brd, TriggerMount.sch]
